GizmoGarageLLC/Gene_1.0/cad/mocks/display_amoled175.stl

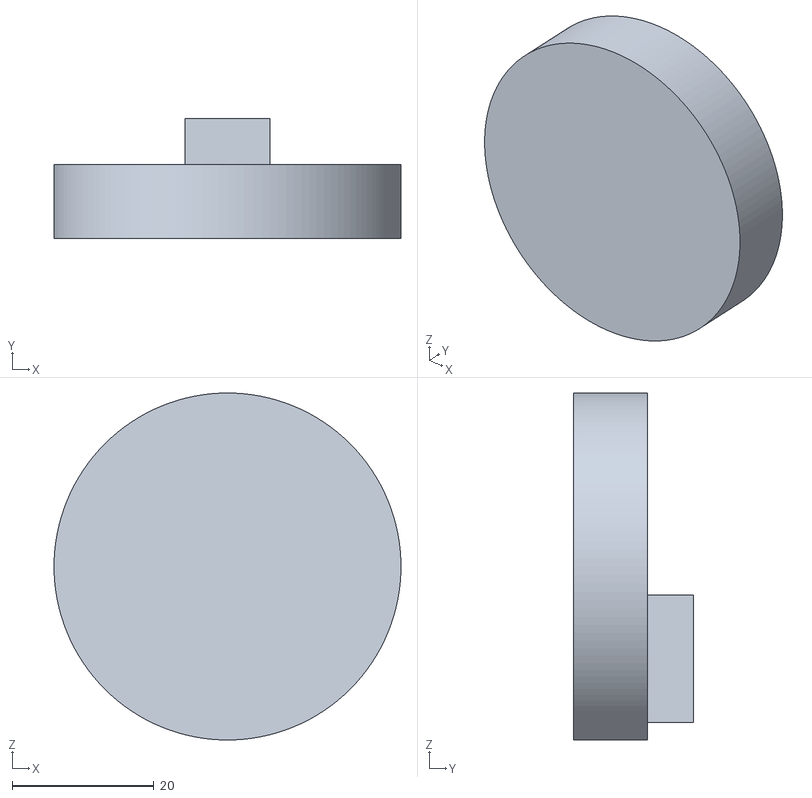
[picture p1: CAD file, 2026-11-10]
cad/mocks/display_amoled175.stl
49.0 x 16.9 x 49.0
