GizmoGarageLLC/Gene_1.0/cad/skull_lcd.stl

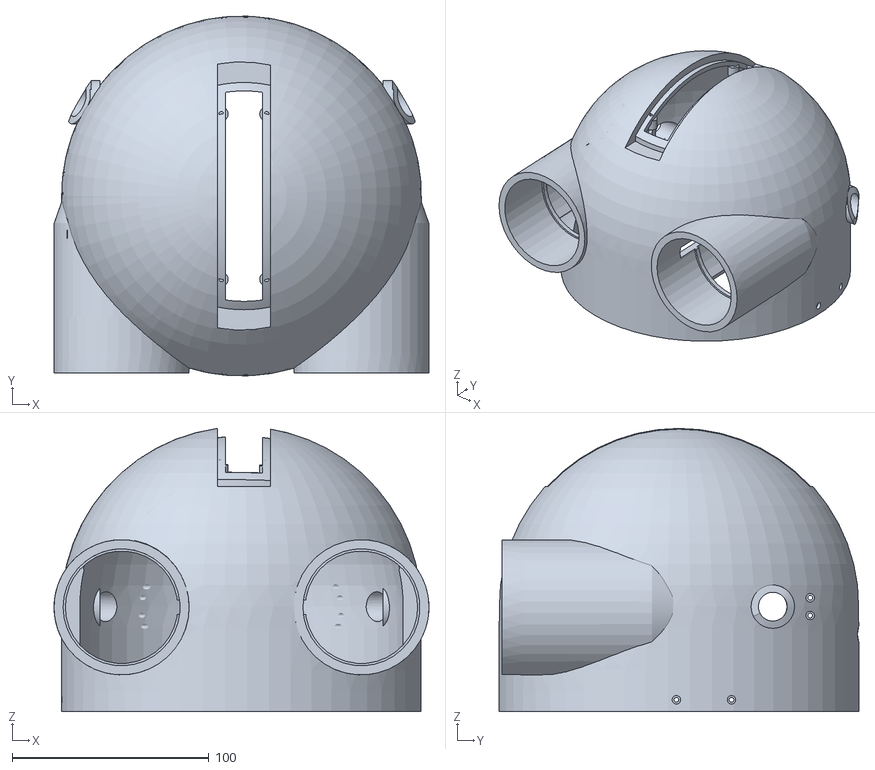
[picture p2: CAD file, 2026-11-11]
cad/skull_lcd.stl
190.6 x 182.8 x 144.0
