GizmoGarageLLC/Gene_1.0/print/parts/25_eye_amoled_harness_x2.stl

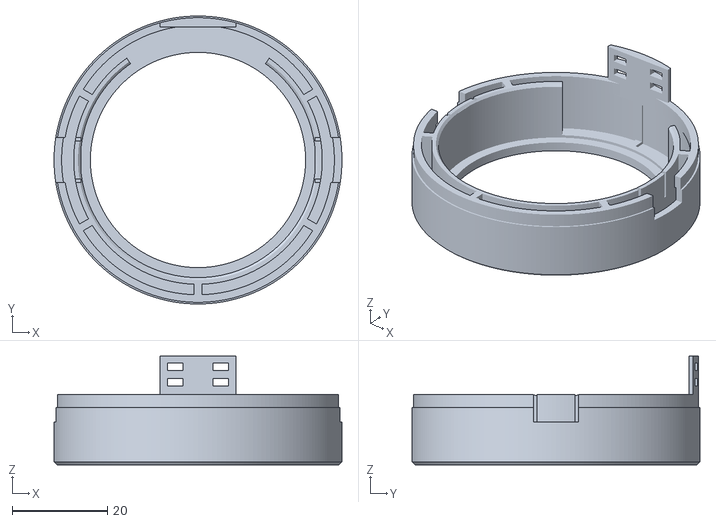
[picture p3: CAD file, 2026-11-11]
print/parts/25_eye_amoled_harness_x2.stl
60.5 x 60.5 x 22.8
