GizmoGarageLLC/Gene_1.0/print/plates/Plate12_amoled_harnesses.3mf

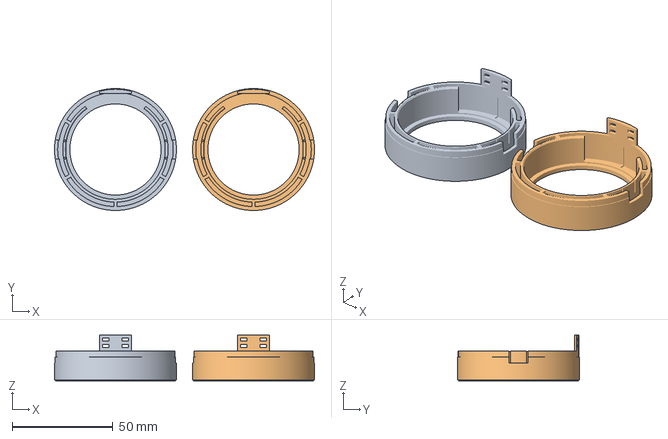
[picture p4: CAD file, 2026-11-11]
print/plates/Plate12_amoled_harnesses.3mf
129.0 x 60.5 x 22.8 mm
amoled_harness_1
amoled_harness_2
