GizmoGarageLLC/Gene_1.0/cad/mocks/display.stl

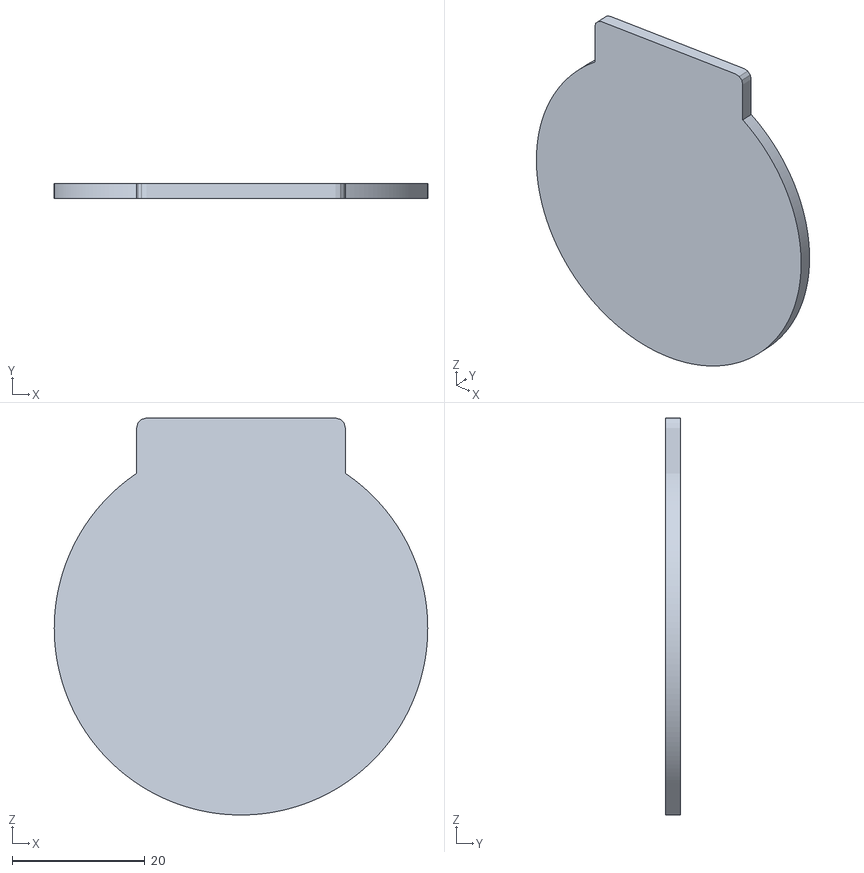
[picture p5: CAD file, 2026-11-10]
cad/mocks/display.stl
56.2 x 2.30 x 59.7
