GizmoGarageLLC/Gene_1.0/cad/mocks/display_driver_board.stl

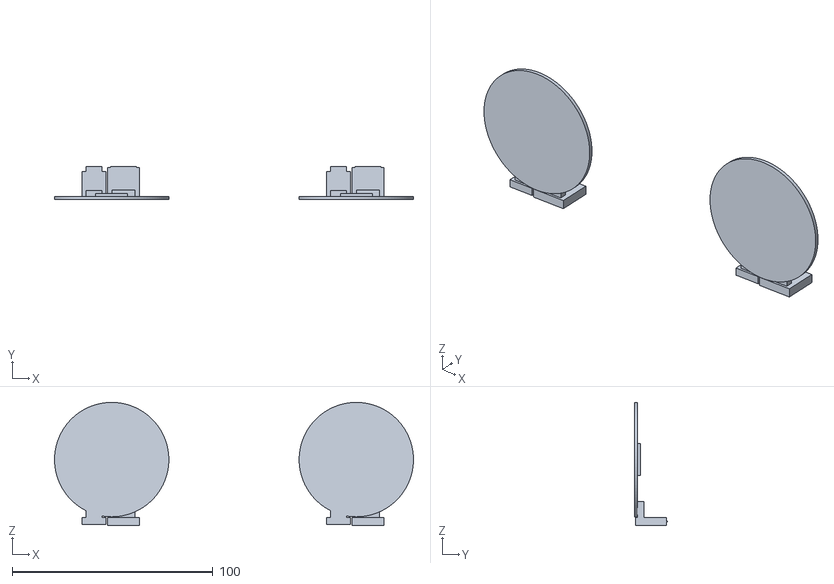
[picture p7: CAD file, 2026-11-10]
cad/mocks/display_driver_board.stl
178.9 x 16.5 x 61.4
