GizmoGarageLLC/Gene_1.0/print/plates/Plate8_changes_2026-10-16.3mf

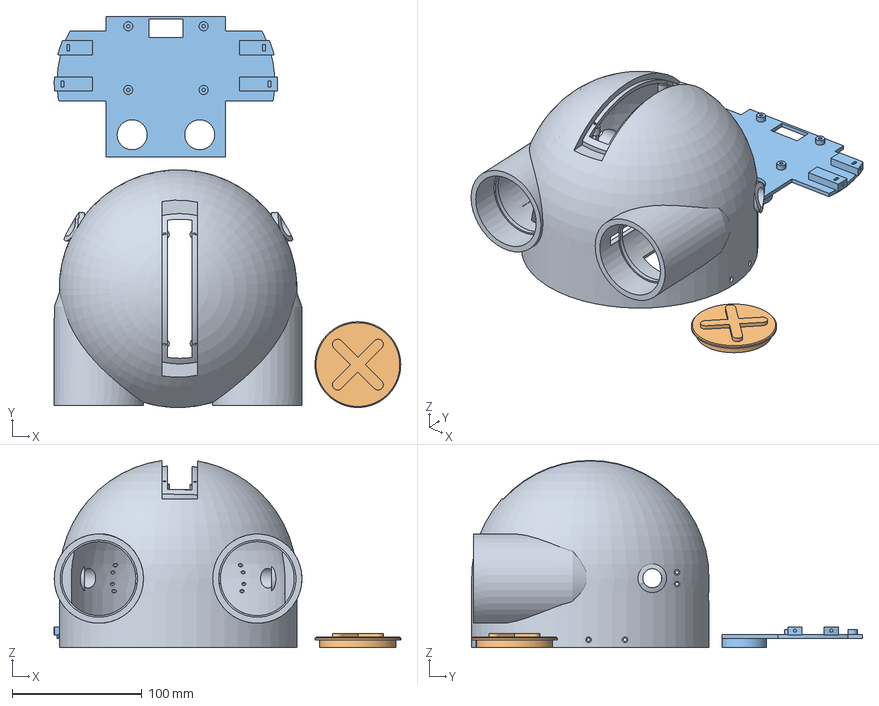
[picture p8: CAD file, 2026-11-10]
print/plates/Plate8_changes_2026-10-16.3mf
266.6 x 300.8 x 144.0 mm
skull_1
eye_x_insert_2
pi_shelf_3
