GizmoGarageLLC/Gene_1.0/cad/eye_display_cradle_L.stl

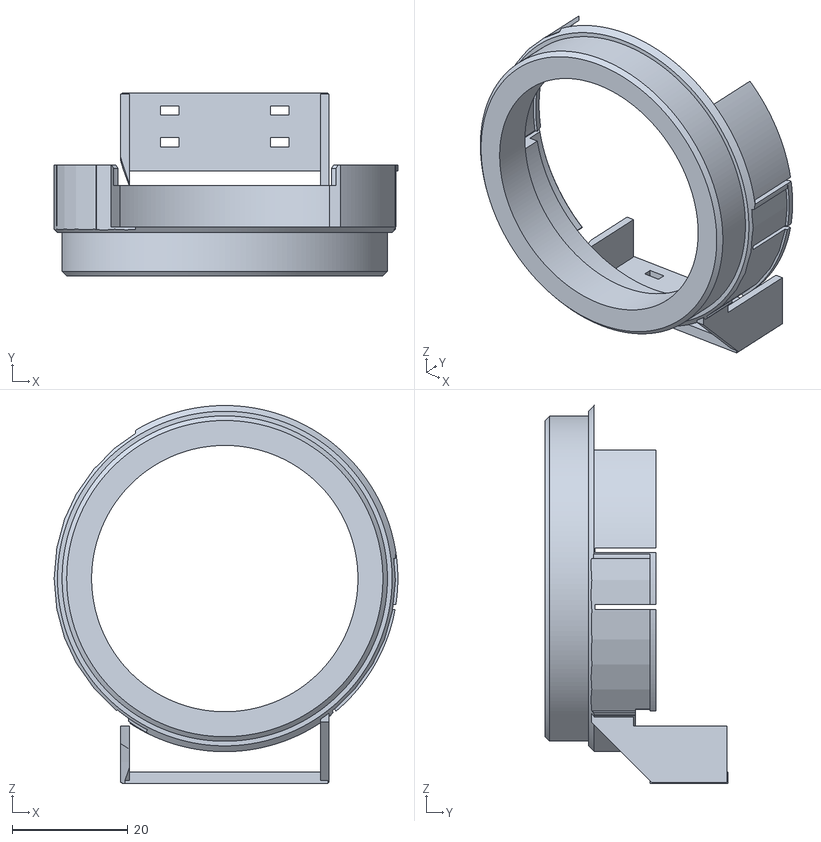
[picture p10: CAD file, 2026-11-10]
cad/eye_display_cradle_L.stl
59.4 x 31.6 x 65.3
