GizmoGarageLLC/Gene_1.0/cad/mocks/power_boards_pb.stl

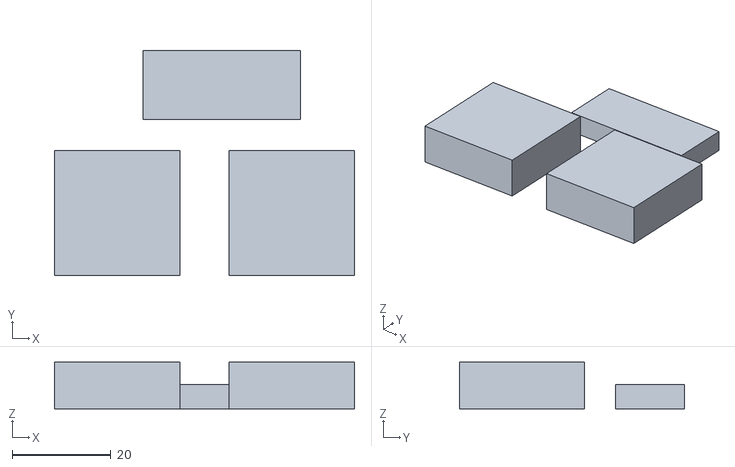
[picture p11: CAD file, 2026-11-10]
cad/mocks/power_boards_pb.stl
60.8 x 45.7 x 9.50
