GizmoGarageLLC/Gene_1.0/print/plates/tree_supports/Plate3_shelf_battery_tree_supports.3mf

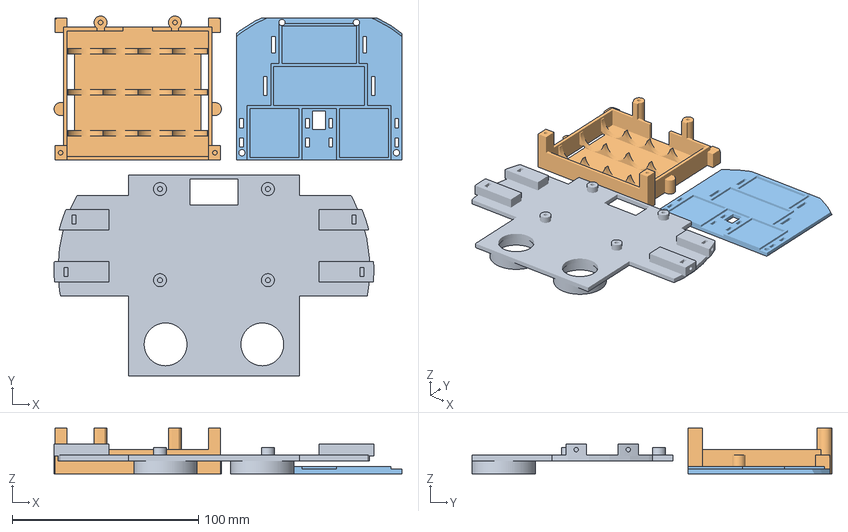
[picture p12: CAD file, 2026-11-11]
print/plates/tree_supports/Plate3_shelf_battery_tree_supports.3mf
187.0 x 193.5 x 24.5 mm
pi_shelf_1
battery_tray_2
battery_deck_3
