GizmoGarageLLC/Gene_1.0/cad/mocks/gpio_plug.stl

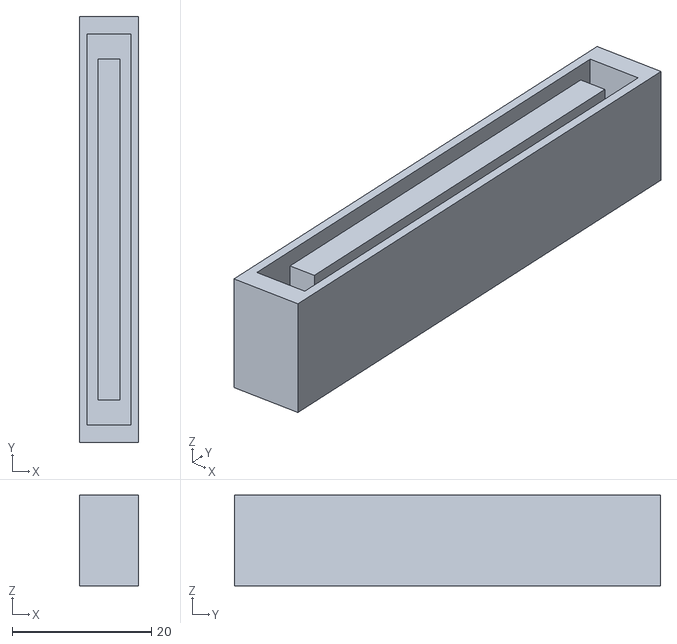
[picture p13: CAD file, 2026-10-30]
cad/mocks/gpio_plug.stl
8.40 x 61.1 x 13.0
