GizmoGarageLLC/Gene_1.0/print/plates/Plate11_eye_cradles.3mf

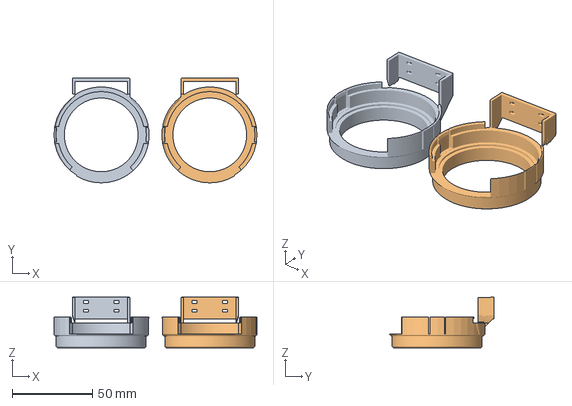
[picture p14: CAD file, 2026-11-10]
print/plates/Plate11_eye_cradles.3mf
126.8 x 65.3 x 31.6 mm
cradle_L
cradle_R
