GizmoGarageLLC/Gene_1.0/cad/battery_deck_pb.stl

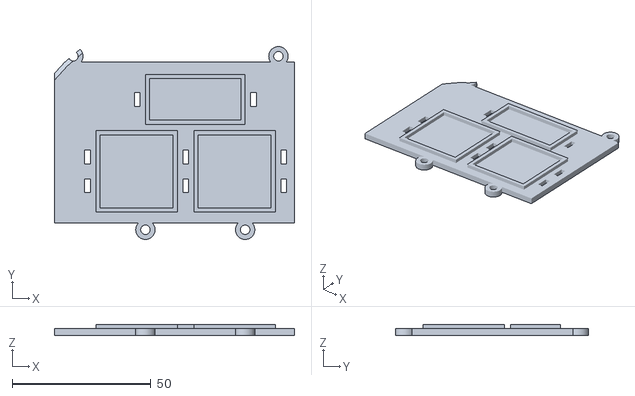
[picture p15: CAD file, 2026-11-10]
cad/battery_deck_pb.stl
86.6 x 69.6 x 4.00
