GizmoGarageLLC/Gene_1.0/cad/mocks/gpio_header.stl

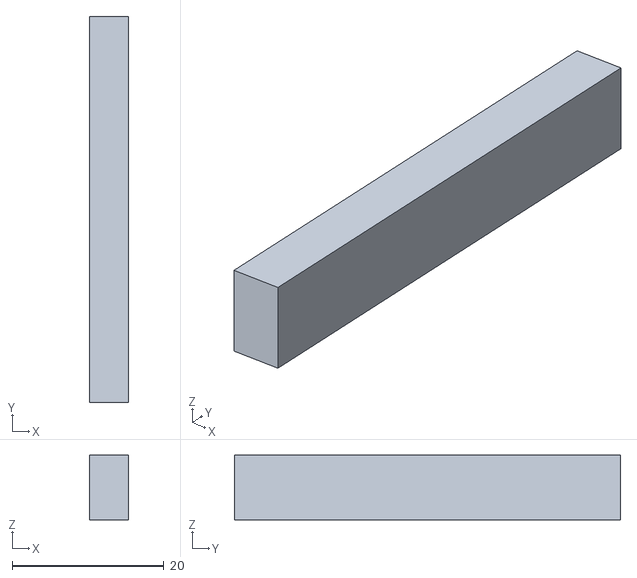
[picture p16: CAD file, 2026-10-30]
cad/mocks/gpio_header.stl
5.08 x 50.8 x 8.50
