GizmoGarageLLC/Gene_1.0/print/plates/Plate9_powerbank_tray_deck.3mf

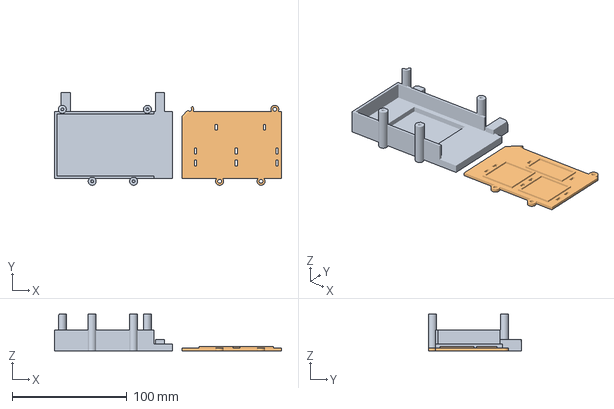
[picture p17: CAD file, 2026-11-10]
print/plates/Plate9_powerbank_tray_deck.3mf
197.4 x 80.5 x 32.0 mm
battery_tray_POWERBANK_1
battery_deck_POWERBANK_2
