GizmoGarageLLC/Gene_1.0/print/plates/tree_supports/Plate7_gpio_flashlight_cover_tree_supports.3mf

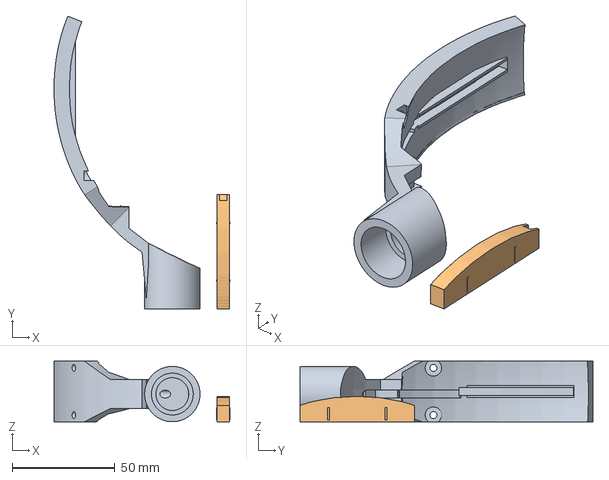
[picture p18: CAD file, 2026-11-11]
print/plates/tree_supports/Plate7_gpio_flashlight_cover_tree_supports.3mf
85.8 x 142.8 x 29.5 mm
gpio_flashlight_1
gpio_cover_2
