GizmoGarageLLC/Gene_1.0/cad/gpio_cover.stl

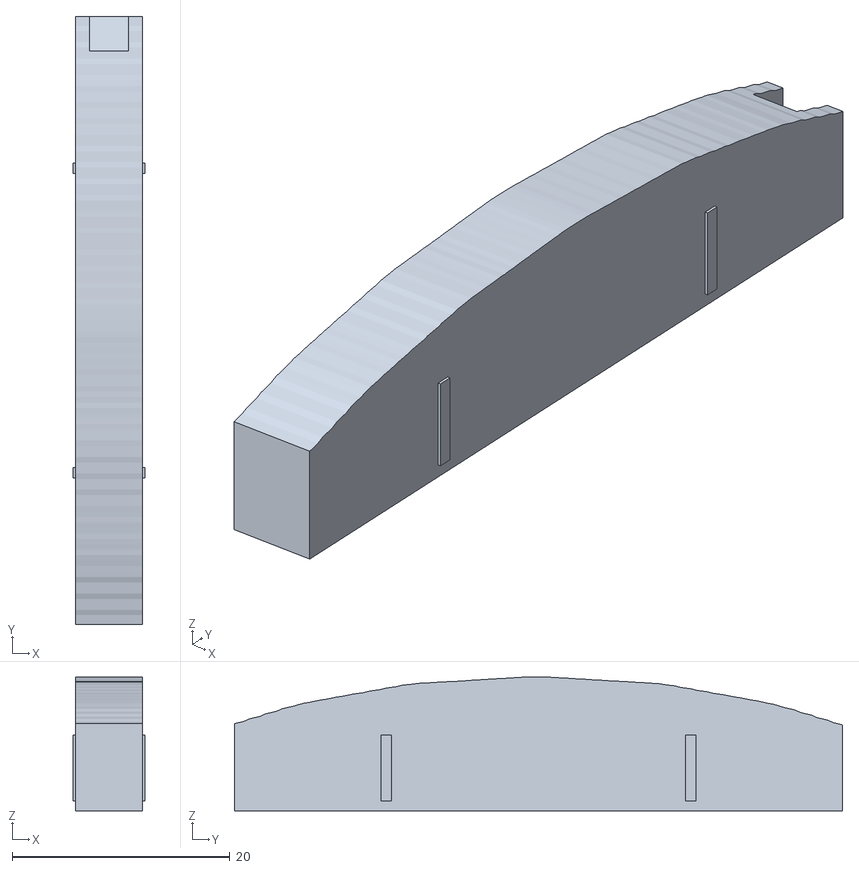
[picture p19: CAD file, 2026-10-30]
cad/gpio_cover.stl
6.60 x 55.9 x 12.3
