GizmoGarageLLC/Gene_1.0/print/parts/18_gpio_flashlight_OPTIONAL_x1.stl

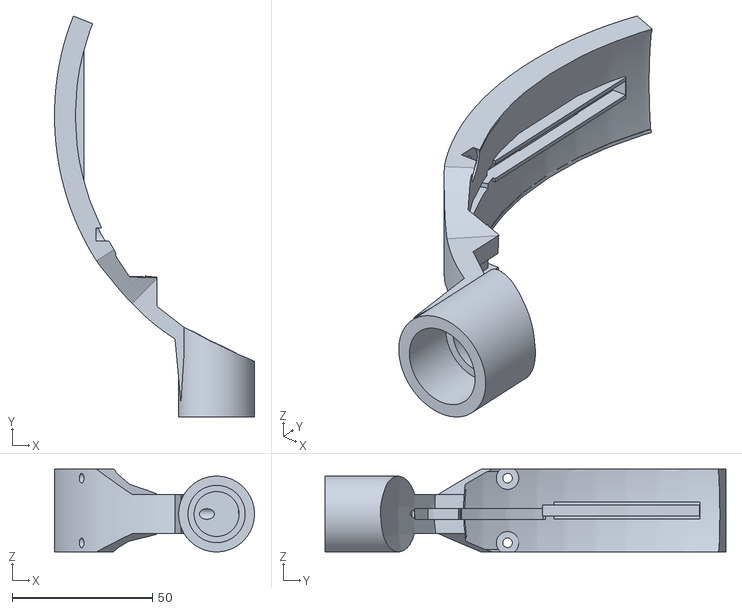
[picture p20: CAD file, 2026-10-30]
print/parts/18_gpio_flashlight_OPTIONAL_x1.stl
71.2 x 142.8 x 29.5
