GizmoGarageLLC/Gene_1.0/print/parts/13_crown_insert_x1.stl

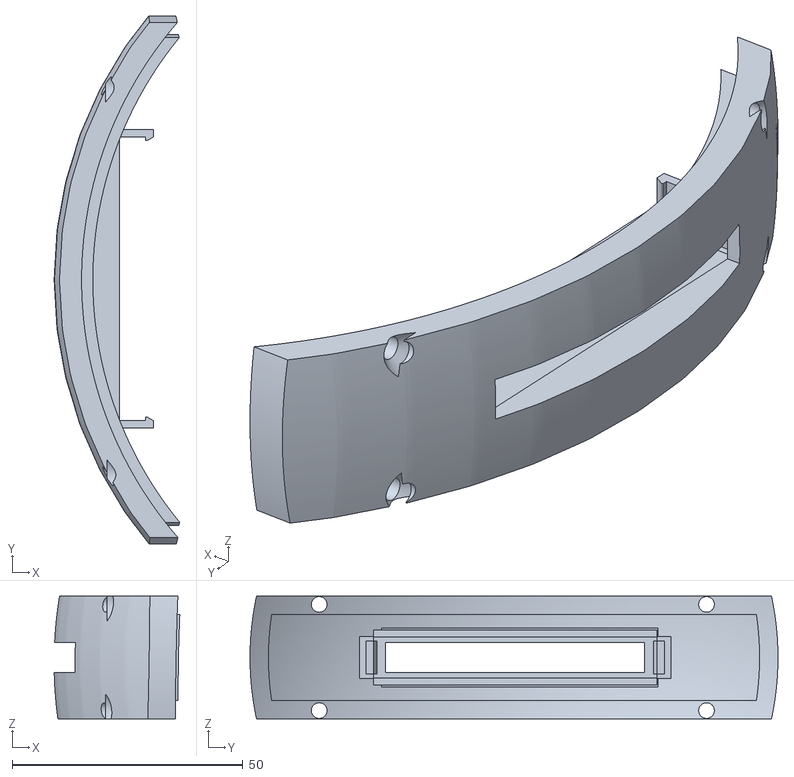
[picture p21: CAD file, 2026-10-30]
print/parts/13_crown_insert_x1.stl
27.3 x 114.5 x 26.6
