GizmoGarageLLC/Gene_1.0/(list of files, cad)

Other CAD files:
print/plates/tree_supports/Plate1_skull_LCD_eyes_tree_supports.3mf
cad/skull.stl
print/parts/01_skull_LCD_EYES_x1.stl
print/plates/Plate1_skull_LCD_eyes.3mf
cad/eye_amoled_harness.stl
print/parts/01_skull_x1.stl
print/parts/24_eye_display_cradle_L_x1.stl
print/plates/Plate1_skull.3mf
cad/eye_display_cradle_R.stl
print/parts/24_eye_display_cradle_R_x1.stl
print/plates/tree_supports/Plate8_changes_2026-10-16_tree_supports.3mf
print/parts/22_battery_deck_POWERBANK_x1.stl
print/plates/Plate7_gpio_flashlight_cover.3mf
print/plates/tree_supports/Plate1_skull_tree_supports.3mf
cad/gpio_flashlight.stl
print/plates/Plate5_crown_insert_handle.3mf
cad/crown_insert.stl
print/parts/19_gpio_cover_OPTIONAL_x1.stl
cad/tools/retired/crown_insert_before_idc_snap.stl
cad/tools/retired/display_driver_board_flexdown.stl
cad/tools/retired/display_mock_before_cradle.stl
