GizmoGarageLLC/Gene_1.0/(commit log)

2026-10-30 Crown insert: GPIO ribbon plug clicks in, no glue
    - The ribbon is the UCTRONICS U6033 (B07D991KMR). Its male end is a shrouded
    2.54 mm male IDC plug, 61.1 x 8.4 x 13.0 (Wurth WR-BHD 612 040 258 21 outline),
    not the assumed 56 x 8.9 x 7.6 bare-pin plug
    - crown_idc_snap.py: new pocket at Y -47.5 with a top lip over the shroud, side
    walls clear of the ribbon, and a hooked cantilever finger at each end that
    snaps under the plug (1.3 % strain at full deflection)
    - Plug mock, flashlight, GPIO cover and the ribbon's last route leg updated;
    check.py and route.py rerun (all 14 runs route)
    - Print parts 13/18/19, Plates 5 and 7 (+ tree-support copies), both sims,
    weights and docs regenerat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
    [13_crown_insert_x1.stl, 18_gpio_flashlight_OPTIONAL_x1.stl, 19_gpio_cover_OPTIONAL_x1.stl, BOM.csv, Plate5_crown_insert_handle.3mf, Plate5_crown_insert_handle_tree_supports.3mf, Plate7_gpio_flashlight_cover.3mf, Plate7_gpio_flashlight_cover_tree_supports.3mf]
2026-11-10 Power bank deck: bucks 35.4 mm apart so they share the middle zip-tie slot
    [22_battery_deck_POWERBANK_x1.stl, Plate9_powerbank_tray_deck.3mf, battery_deck_pb.stl, power_boards_pb.stl]
2026-11-10 Eye board cradles: LCD and driver board held as one rigid unit
    The LCD flex and the flat HDMI/USB leads kept breaking because the driver
    board hung on them. New handed cradles (L/R) replace the retainer ring:
    front ring 0.2 mm behind the glass, shoulder on the carrier, snap seat for
    the 57 mm board, and a tie plate under the flat plug ends for the leads.
    Lead-in chamfers; install path found and checked (0 contacts, both eyes).
    - Real LCD outline and the board turned 180 deg with the bought leads' flat
    90 deg plug ends in the mocks; both ribbons run back into the head
    (mini-HDMI UP-angled end replaces the chenyang DOWN-angled one)
    - Clearance all round each eye >= 0.65 mm; jaw sweep unch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
    [24_eye_display_cradle_L_x1.stl, 24_eye_display_cradle_R_x1.stl, Plate11_eye_cradles.3mf, display.stl, display_driver_board.stl, display_driver_board_flexdown.stl, display_mock_before_cradle.stl, eye_display_cradle_L.stl]
2026-11-10 Build order: couplers on the servo horns first, home servos before the jaw
    Couplers (drive hubs) are bolted to the horns on the bench, D-bore flat at the
    top, before the servos go on their brackets. The servos are homed after they
    are mounted and wired, and the jaw goes on closed so the pivot pins slide into
    the couplers flat to flat. Fix any misalignment with Homing Offset or by
    re-turning the coupler, never by forcing the jaw.
2026-11-10 AMOLED eyes option, eyes 15 mm forward, one sim with a Setup switch
    - eye_amoled.py: harness and mock for a Waveshare 1.75" AMOLED ESP32-S3 board
    (replaces carrier + cradle; one USB-C lead per eye)
    - skull_v7_eyes_forward.py: whole eye stack 15 mm forward in the barrels
    (EYE_DY in parts.py; route.py eye cable starts and the sim's screen, lens
    and beam positions follow it). This skull is AMOLED-only: the 2.1" LCD
    cradles and driver boards hit the barrel bottoms; LCD eyes use the retired
    pre-move skull
    - check/occ_all/route/mass take GENE_POWER and GENE_EYES; results per setup
    - sim/head_sim.html switches battery (pack / power bank) and eyes (LCD /
    AMOLED) in place; replaces head_s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
    [01_skull_x1.stl, Plate1_skull.3mf, Plate8_changes_2026-10-16.3mf, display_amoled175.stl, eye_amoled_harness.stl, eye_display_cradle_L.stl, skull.stl]
2026-11-11 Two skulls, one per eye option; all four setups rerun
    - LCD eyes get their own skull (cad/skull_lcd.stl, print 01_skull_LCD_EYES_x1,
    Plate 1 LCD): the skull from before the eyes came forward. skull.stl stays the
    AMOLED skull, eyes 15 mm forward.
    - parts.py / route.py / export.py pick the skull and eye shift per GENE_EYES;
    LCD results match 3a57384 again (cradles, Plate 11, cables, checks).
    - AMOLED harness print file and Plate 12; tree supports regenerated (Plate 1 LCD added).
    - bom_tables.py rebuilds BOM.md section 5 and BOM.csv from all four cable runs.
    - Sim: eye rig moves per setup, skull/bezel/camera/pupil swap, defaults on a desk
    (no neck, flashlight, cones or POV; GPIO cover o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
    [01_skull_LCD_EYES_x1.stl, 25_eye_amoled_harness_x2.stl, BOM.csv, Plate12_amoled_harnesses.3mf, Plate1_skull_LCD_eyes.3mf, Plate1_skull_LCD_eyes_tree_supports.3mf, Plate1_skull_tree_supports.3mf, Plate2_jaw_tree_supports.3mf]
2026-11-11 Wiring diagrams for the power bank and AMOLED eye options
    - wiring_power_powerbank.svg: P50 -> 15 V PD trigger -> switch -> fuse -> both bucks.
    - wiring_loads_amoled.svg: loads diagram with the two AMOLED boards on USB-C
    instead of the LCDs, HDMI and micro-USB power.
    - WIRING.md: table of which diagrams to follow for each of the four setups;
    the loads diagrams note the buck input can be the BMS or the PD trigger.
